ska-sa/roach1_mechanical/Images/enclosure.jpg

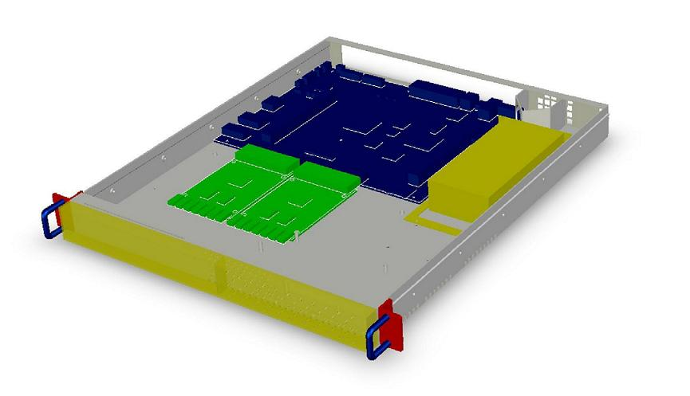
Images/enclosure.jpg
