ska-sa/roach1_mechanical/Images/thermal.jpg

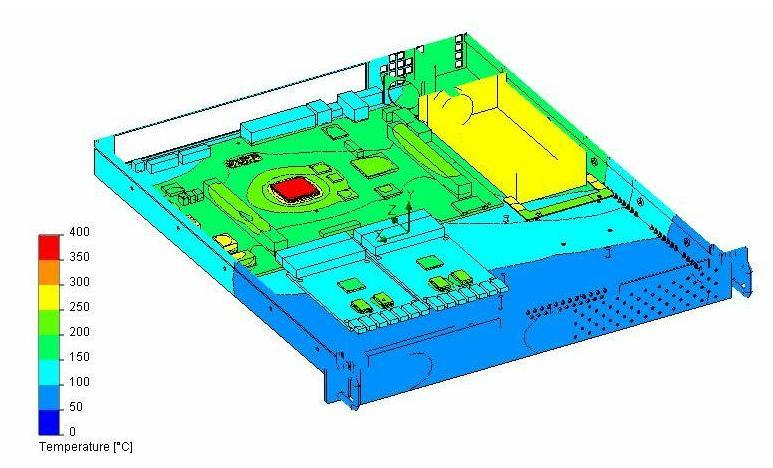
Images/thermal.jpg
