ska-sa/roach1_mechanical/Chassis/1u_chassis_10Mar08/1U_CHASSIS_iss2.pdf

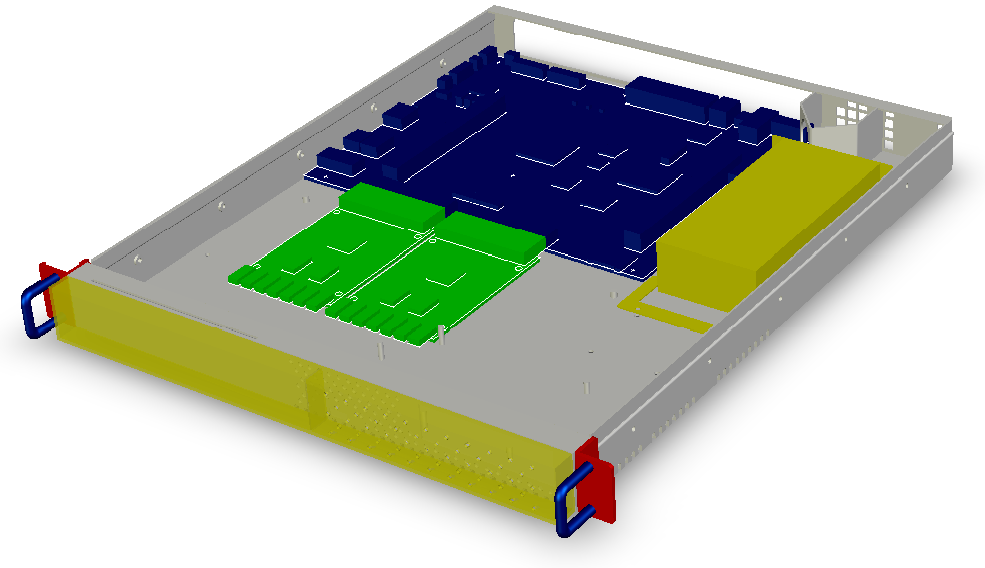
[picture p22: figure]
