ska-sa/roach1_mechanical/Chassis/1u_chassis_10Mar08/1u_chassis2.jpg

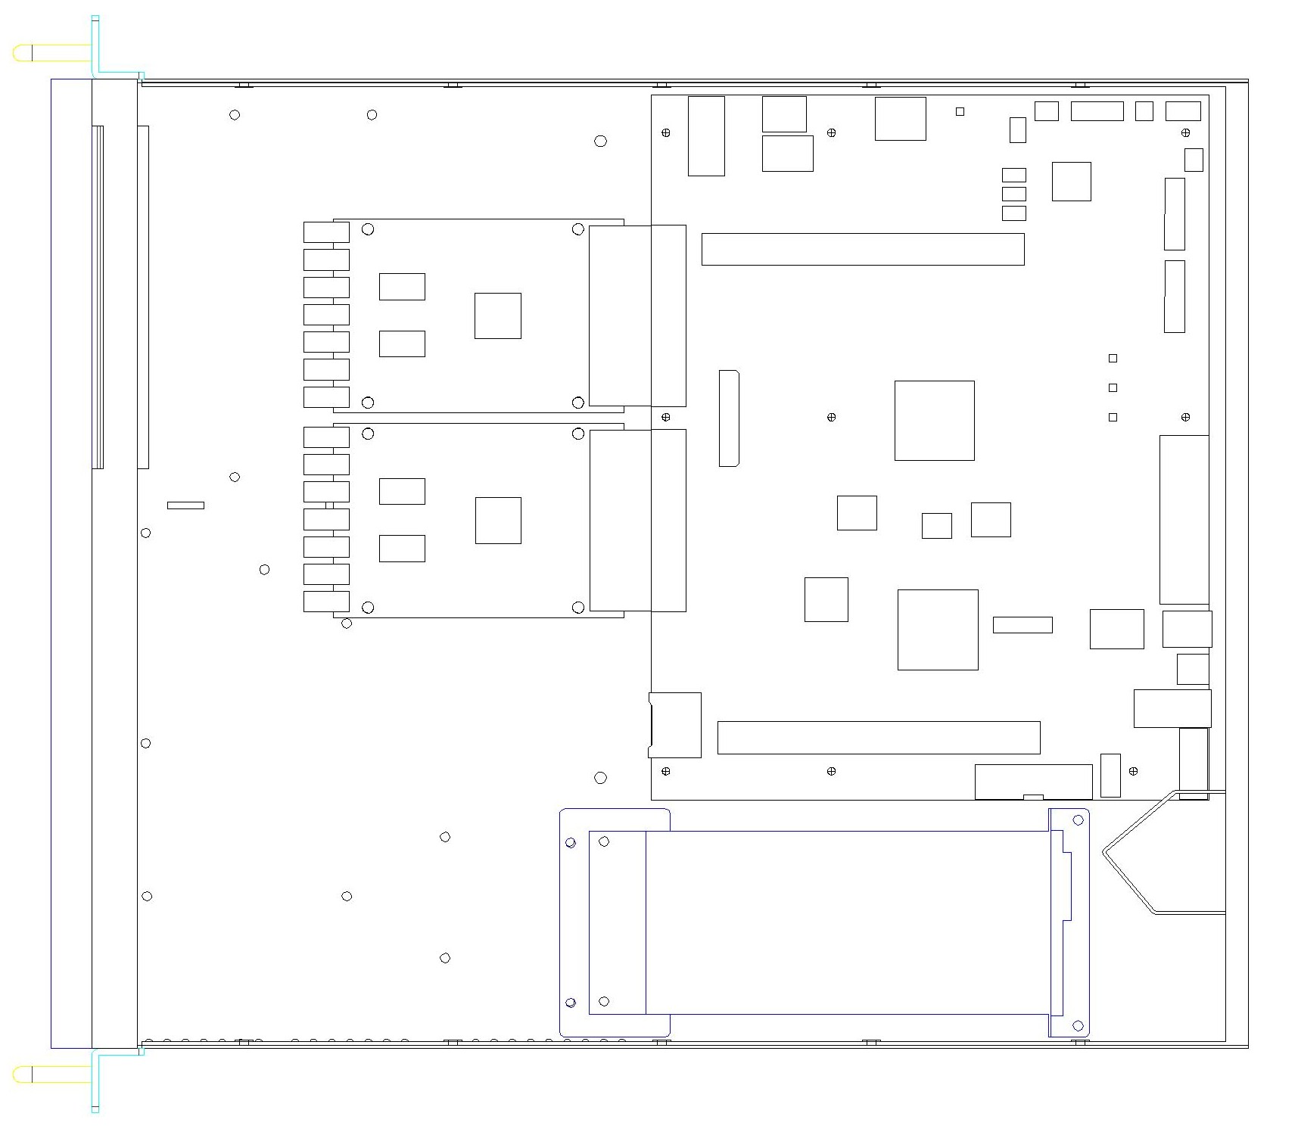
Chassis/1u_chassis_10Mar08/1u_chassis2.jpg
