ska-sa/roach1_mechanical/Images/1u_chassis_layout.jpg

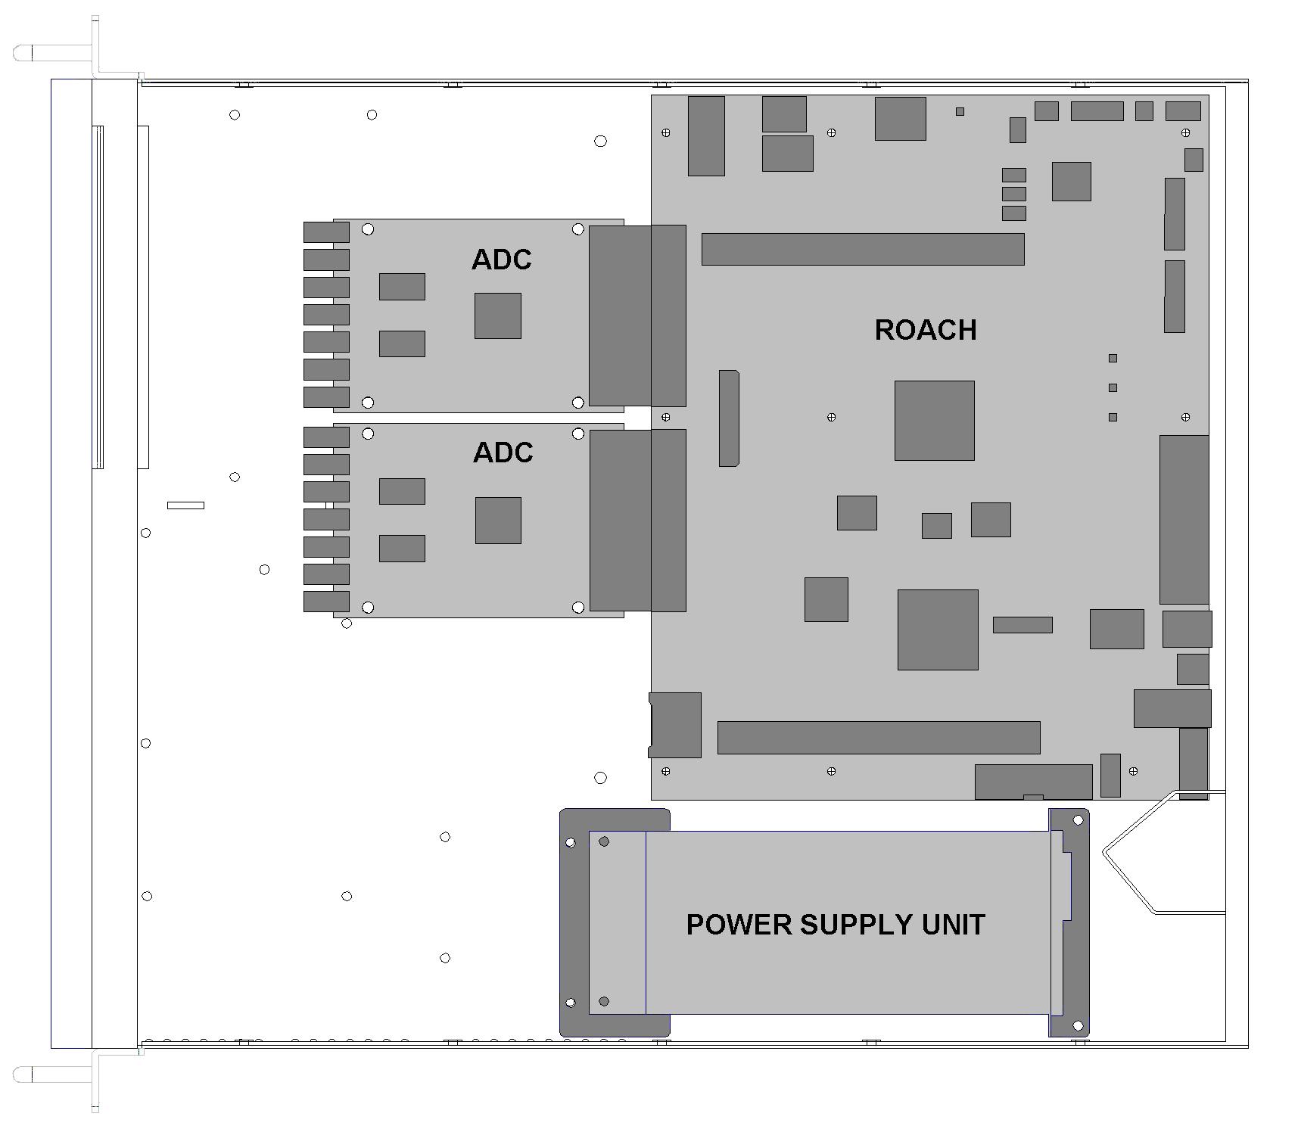
Images/1u_chassis_layout.jpg
