ska-sa/roach1_mechanical/Partslist/Partslist.pdf

Sheet1

Page 1

Item # | Name | Part Number | Manufacturer | Description
1 | ROACH | ROACH | SA SKA
2 | | | Casper
3 | Power Supply | CP-01025 | ? | ATX Switching Power Supply
4 | Enclosure | | ?
5 | Cables | | ?

ROACH Partslist

iADC | iADC
