ska-sa/roach1_mechanical/component heights vs stand-off length.ods

Stand-off length vs component heights |  |  |  | All units mm
Standard | 1U Height (Total) | 1U Height (actual) | Chassis Base Thickness | Stand-off Height | PCB Thickness | Space beneath board | Bottom clearance | Max component height (bottom) | Top clearance | Chassis Cover Thickness | Max component height (top) | DDR2 in socket height | Heatsink + FPGA height | Airgap
TEB | 44.45 | 43.18 | 1 | 3.96 | 2 | 2.96 | 1 | 1.96 | 1 | 1 | 36.22 | 33.6 | 23 | 13.22
ATX | 44.45 | 43.18 | 1 | 6.35 | 2 | 5.35 | 1 | 4.35 | 1 | 1 | 33.83 | 33.6 | 23 | 10.83
