ska-sa/roach1_mechanical/Partslist/Partslist.ods

ROACH Partslist
Item # | Name | Part Number | Manufacturer | Description
1 | ROACH | ROACH | SA SKA
2 | iADC | iADC | Casper
3 | Power Supply | CP-01025 | ? | ATX Switching Power Supply
4 | Enclosure |  | ?
5 | Cables |  | ?
