ska-sa/roach1_mechanical/Thermal/Power_Dissipation.ods

ROACH Maximum Power Dissipation Estimate
Item # |  | Power Dissipation (W) |  | # Of items | Total | Comments
1 | LT1963AEQ |  | 2.95 | 4 | 11.8 | 1.5A x (5V - 3.3V) + (0.08A x 5V)
2 | AT84AD001BCTD |  | 1.7 | 2 | 3.4
3 | Virtex 5 SX95 |  | 40 | 1 | 40 | Worst Case
4 | AMCC 440EPC |  | 3.77 | 1 | 3.77
5 | XC2C256 |  | 1.67 | 1 | 1.67
6 | DP83865 |  | 1.64 | 1 | 1.64 | 1.64
7 | K7S3218T4C-FC40 |  | 1.71 | 2 | 3.42 | 1.71
8 | S29AL032D |  | 0.11 | 1 | 0.11 | 0.11
9 | PTH05T210WAD |  | 5 | 1 | 5 | Maximum Rating
10 | PTH08T230WAD |  | 2.5 | 1 | 2.5 | Maximum Rating
11 | PTH08T240WAD |  | 3.75 | 1 | 3.75 | Maximum Rating
12 | PTH08T220WAD |  | 5.5 | 1 | 5.5 | Maximum Rating
13 | AFS600 |  | 0.66 | 1 | 0.66 | General Design Example
14 | DIMM Memory Module |  | 6 | 2 | 12 | General Approximation Based on Micron Power Calculator
15 | TPS74401RGWT |  | 2.74 | 4 | 10.96 | Maximum Rating
16 | FJD3076TM |  | 10 | 1 | 10 | Maximum Rating
17 | Power Supply |  | 250 | 0 | 0 | Maximum Rating
 |  |  |  |  | 116.18
