ska-sa/roach1_mechanical/Chassis/Datapack NSessions/1u_chassis_asm.stp

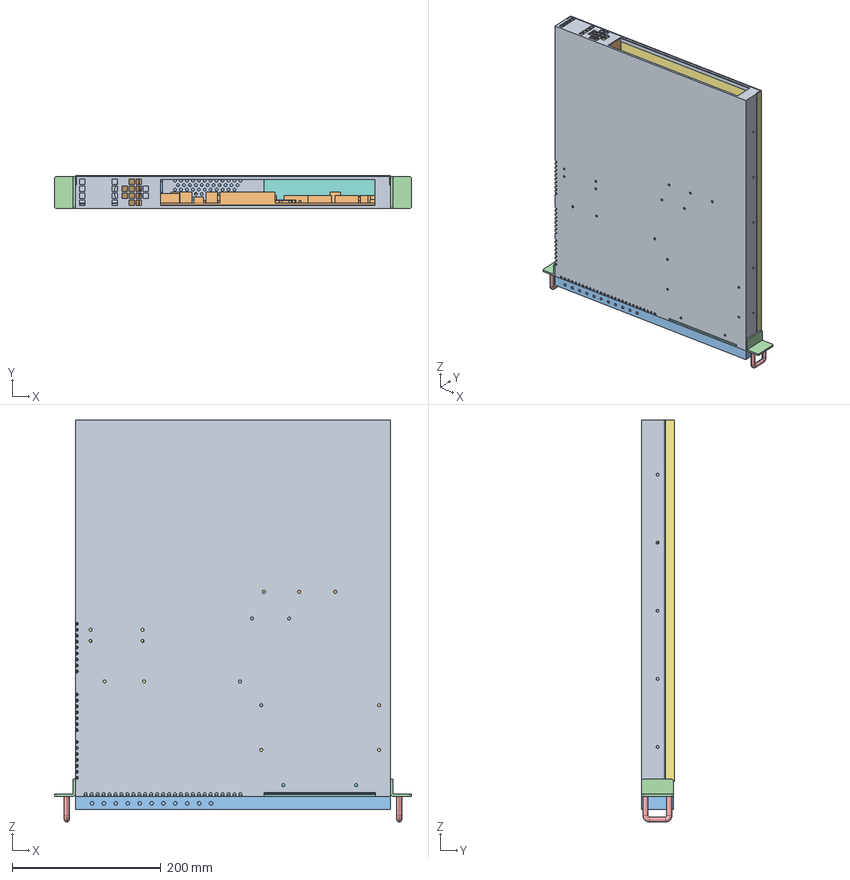
[picture p25: CAD file, 2008-03-11]
Chassis/Datapack NSessions/1u_chassis_asm.stp
480.0 x 44.5 x 540.5 mm
1U_CHASSIS
FAN_COVER
FRONT_COVER
BRACKET x 2
HANDLE x 2
STUD1 x 10
COVER
FRONTLEFT_COVER
POWER_SUPPLY
ROACH_PCB_MECH_LAYOUT
ADC x 2
