ska-sa/roach1_mechanical/PCB/ADC.dxf

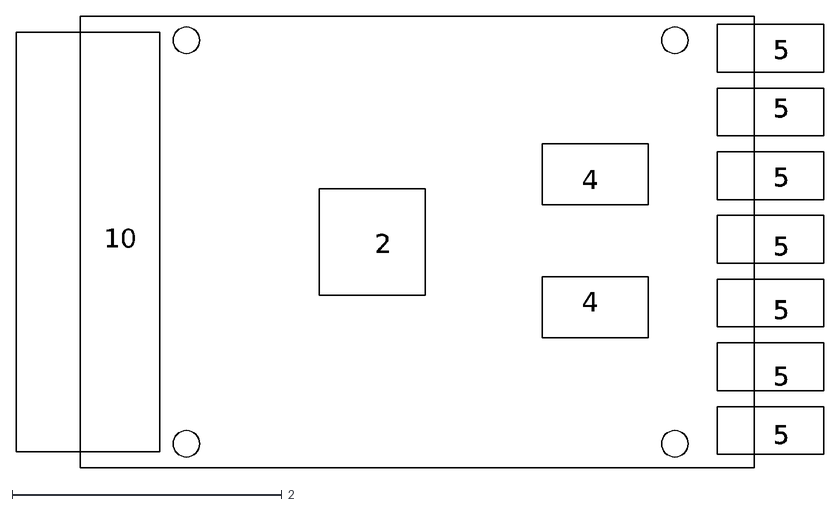
[picture p26: CAD file, 2008-02-27]
PCB/ADC.dxf
4
2
10
5
