ska-sa/roach1_mechanical/PCB/roach_pcb_mech_layout.dxf

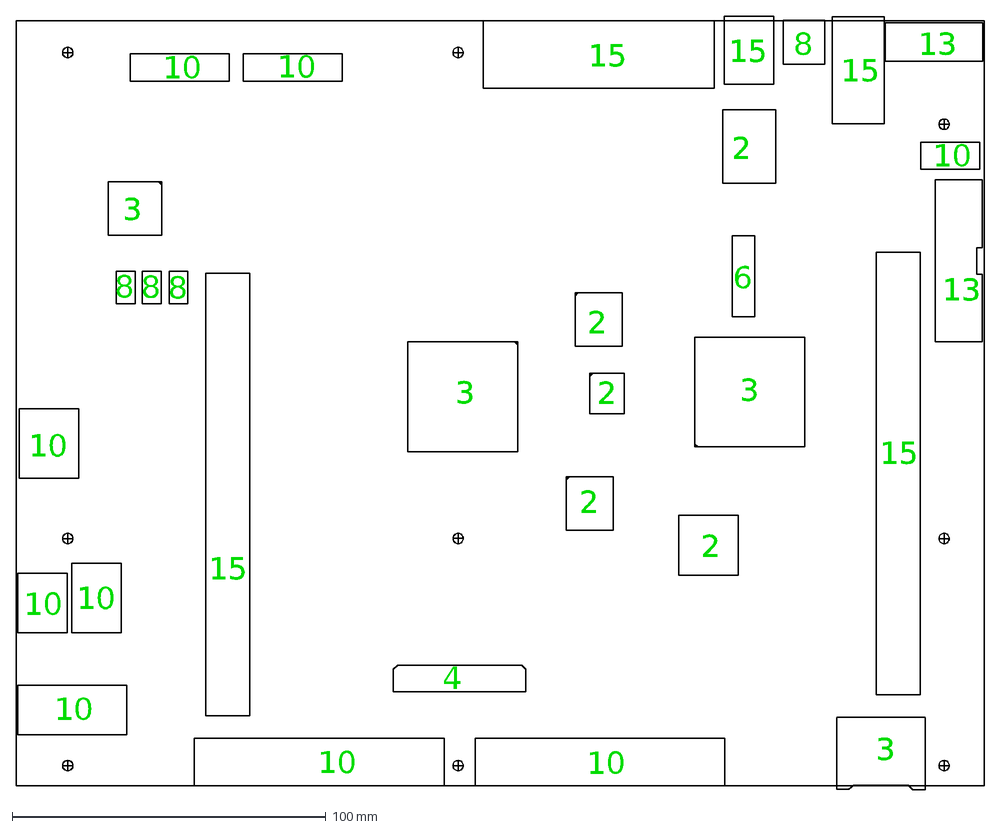
[picture p27: CAD file, 2007-12-19]
PCB/roach_pcb_mech_layout.dxf
3
15
2
6
10
4
8
13
