ska-sa/roach1_mechanical/(list of files, cad)

Other CAD files:
ATX.skp
