ska-sa/roach1_mechanical/(commit log)

2007-05-30 Transferred Roach, iBOB1.5 and Sequoia designs to ROACH svn
    [ATX.skp]
2007-06-07 Added stand-off length spreadsheet
    [component heights vs stand-off length.ods]
